Andy4495/BoydPrinter/extras/jpg/BoydWithUno.jpg

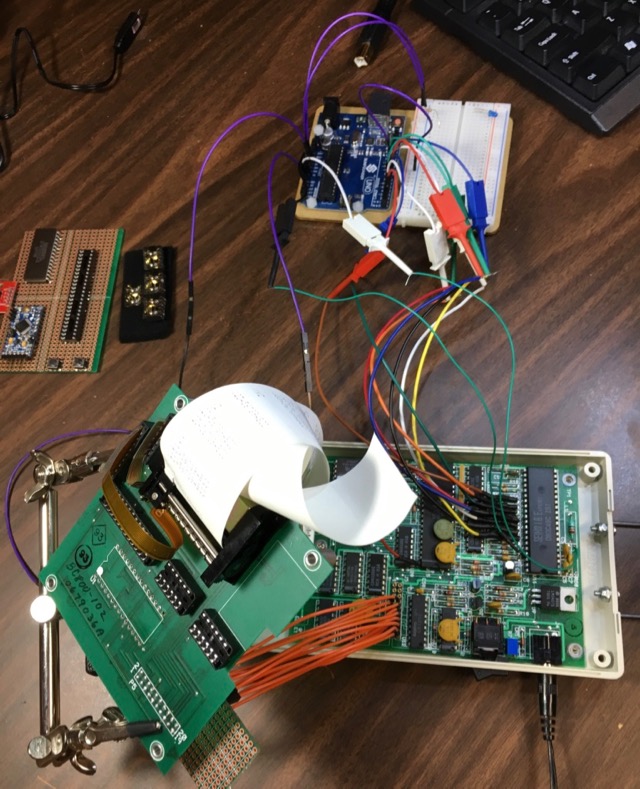
extras/jpg/BoydWithUno.jpg
