Andy4495/BoydPrinter/(commit log)

2018-02-16 Clarify printff() and clean up formatting.
2018-03-03 Add const to println char* parameter
2023-09-15 Update example for stm32 and esp compatibility.
2024-09-30 Switch to lychee for link checks
